GTX-GSO/O2Analyzer/cad/stl/tee.stl

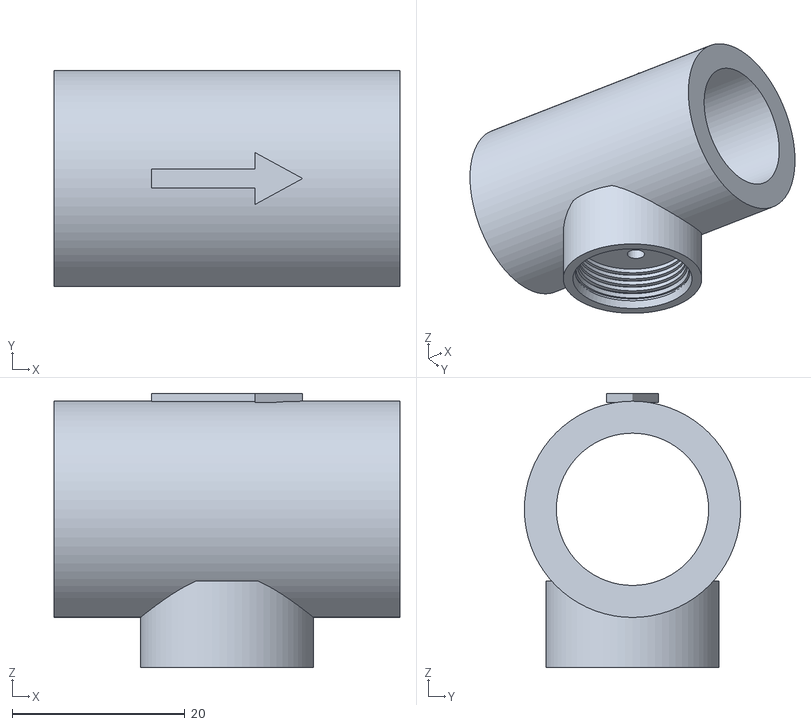
[picture p1: CAD file, 2026-10-18]
cad/stl/tee.stl
40.0 x 25.0 x 31.7
