GTX-GSO/O2Analyzer/cad/stl/bottom_cap.stl

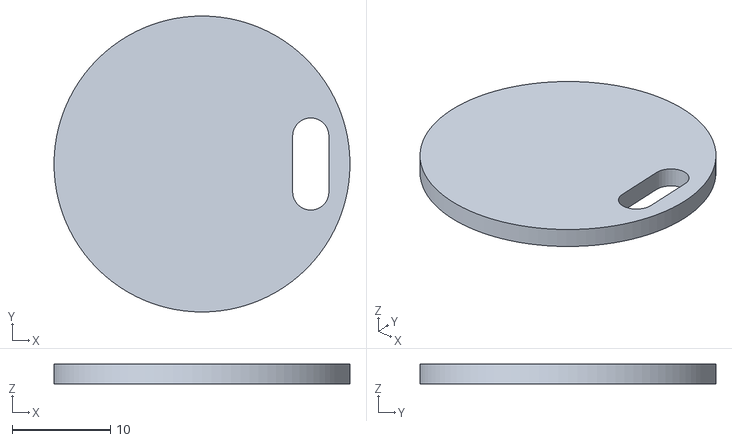
[picture p2: CAD file, 2026-10-18]
cad/stl/bottom_cap.stl
30.2 x 30.2 x 2.00
