GTX-GSO/O2Analyzer/cad/stl/body.stl

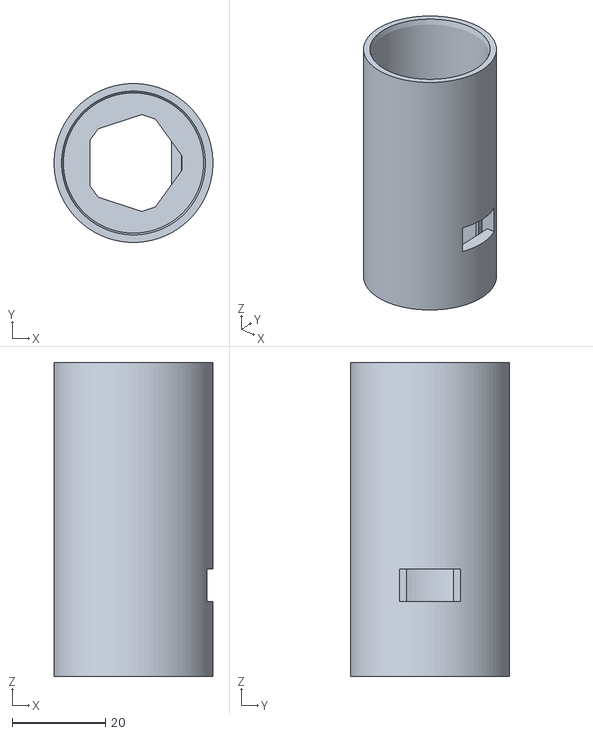
[picture p3: CAD file, 2026-10-18]
cad/stl/body.stl
34.0 x 34.0 x 67.2
