GTX-GSO/O2Analyzer/cad/stl/body_lower.stl

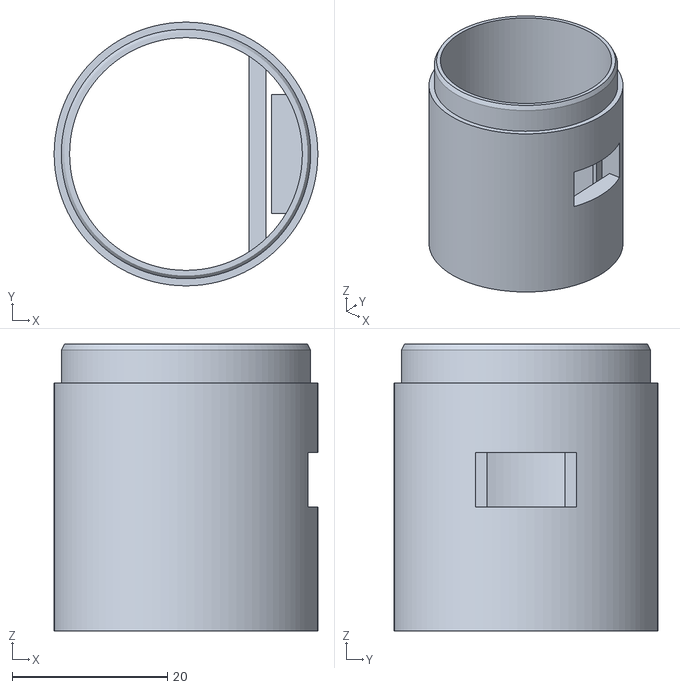
[picture p4: CAD file, 2026-10-18]
cad/stl/body_lower.stl
34.0 x 34.0 x 37.0
