GTX-GSO/O2Analyzer/cad/stl/top_cap.stl

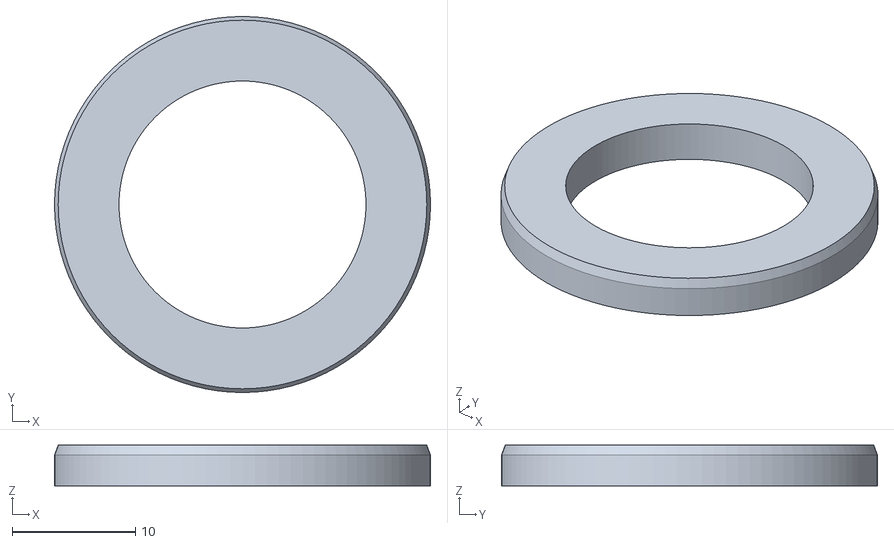
[picture p5: CAD file, 2026-10-18]
cad/stl/top_cap.stl
30.4 x 30.4 x 3.30
