GTX-GSO/O2Analyzer/cad/stl/body_upper.stl

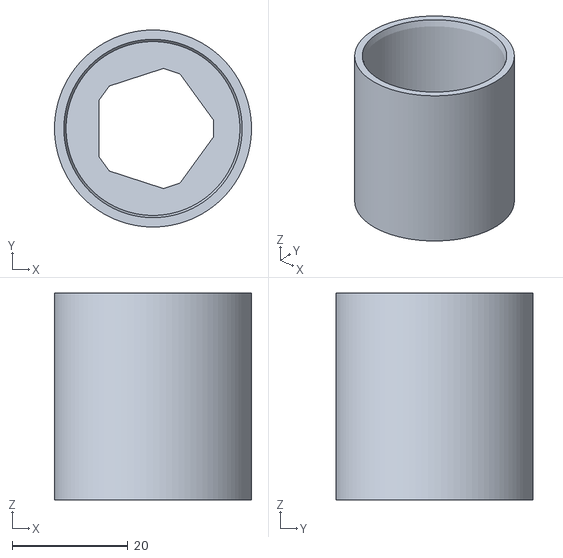
[picture p6: CAD file, 2026-10-18]
cad/stl/body_upper.stl
34.0 x 34.0 x 35.7
