GTX-GSO/O2Analyzer/cad/export_all_print.scad

use <o2analyzer_enclosure.scad>
body_lower();
translate([52, 0, 0]) body_upper();
translate([52, 45, 0]) top_cap();
translate([0, 52, 0]) bottom_cap();
