GTX-GSO/O2Analyzer/cad/export_ao_elec_gauge.scad

use <ao_elec_gauge.scad>
gauge_female();
