GTX-GSO/O2Analyzer/cad/export_body.scad

use <o2analyzer_enclosure.scad>
// Assembled preview (lower + upper); print halves via export_body_lower/upper
body();
