GTX-GSO/O2Analyzer/cad/export_body_lower.scad

use <o2analyzer_enclosure.scad>
body_lower();
