GTX-GSO/O2Analyzer/cad/export_body_upper.scad

use <o2analyzer_enclosure.scad>
body_upper();
