GTX-GSO/O2Analyzer/cad/export_bottom_cap.scad

use <o2analyzer_enclosure.scad>
bottom_cap();
