GTX-GSO/O2Analyzer/cad/export_restrictor.scad

use <flow_restrictor_tee.scad>
restrictor_core();
