GTX-GSO/O2Analyzer/cad/export_tee.scad

use <flow_restrictor_tee.scad>
tee();
