GTX-GSO/O2Analyzer/cad/export_tee_set.scad

use <flow_restrictor_tee.scad>
tee();
