GTX-GSO/O2Analyzer/cad/export_top_cap.scad

use <o2analyzer_enclosure.scad>
top_cap();
